deton/heatmapdrone/(commit log)

2018-03-31 Add sensortest.ino to check VCNL4010
2018-03-31 Add VL53L0X ToF sensor
2018-04-01 Add ADT7410 temperature sensor
2018-04-07 Update comment: fix max result of VL53L0X from 8190 to 8192
    [sensortest.ino]
2018-04-07 Vertical movement by distance from ceiling using ToF sensor
2018-04-08 forward or turn 90 degree by sensing result of front ToF sensor
2018-04-08 Fix land is ignored
    [heatmapdrone.ino]
2018-04-08 Fix forward is ignored when vertical movement is required
    [heatmapdrone.ino]
2018-04-10 log sensor/flight data and Serial.print if 'r' key is pressed on Serial
2018-04-14 Trace ceiling light line by turn 20/-20 degrees on darker/lighter
2018-04-16 Avoid useless turn left->right->left without forward
    [heatmapdrone.ino]
2018-04-17 Change to use dark/light threshold for ambient light sensor value
2018-04-17 Shorten sensing interval to reduce drift while hovering
    [heatmapdrone.ino]
2018-04-17 Fix not to fly up after land request
    [heatmapdrone.ino]
2018-04-17 Disable verbose Serial.print() while BLE service/characteristic discover
2018-04-22 Add DRIFT_OFFSET to fix drift on forward
    [heatmapdrone.ino]
2018-04-24 flattrim just after PS_EAST/PS_WEST to reduce drift on forward but no effect
    [heatmapdrone.ino]
2018-04-25 wait turn for short sensing interval
    [heatmapdrone.ino]
2018-04-27 Add ticker to keep sending forward request to reduce drift
    [heatmapdrone.ino]
2018-05-09 Make sure to stop forward before and after turn to reduce drift
    [heatmapdrone.ino, parrotmambo.cpp]
2018-05-27 Change light sensor from VCNL4010 to two NJL7502L
2018-06-03 Change near wall wait count to wait millis
2018-06-06 Wait before changing right/left to avoid no effect
    [heatmapdrone.ino]
2018-06-10 Use larger CHANGEFLY_WAIT to trace light line
2018-06-11 Add needPilotRequest() to interrupt for pilot interval > sensing interval
2018-06-19 Decide left/right movement if diff < 10
    Add RIGHT_OFFSET to avoid drift.
    [heatmapdrone.ino]
2018-06-27 Keep previous right value on darker area to reduce drift
    [heatmapdrone.ino]
2018-06-29 Revert "fly to right/left without forward on dark to return light line early"
    no effective result.
    This reverts commit 9417b6690db684aac8a1691bfd36cb2bb03f0737.
    [heatmapdrone.ino]
2018-07-01 Update schematic.ce3: use D7 instead of D6
2018-07-08 fly more right/left just after changing right/left wait
    remove prev_keep_right that makes drift between lights
    [heatmapdrone.ino]
2018-07-13 add more offset on W2E/E2W to avoid bump to the wall
    [heatmapdrone.ino]
2018-07-28 Update README: add sample result
    [sampleresult.csv]
